zinzza/PlotBridge/Images/plotter1.png

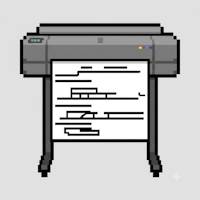
Images/plotter1.png
