zinzza/PlotBridge/Hardware/PlotBridge-schematic.pdf

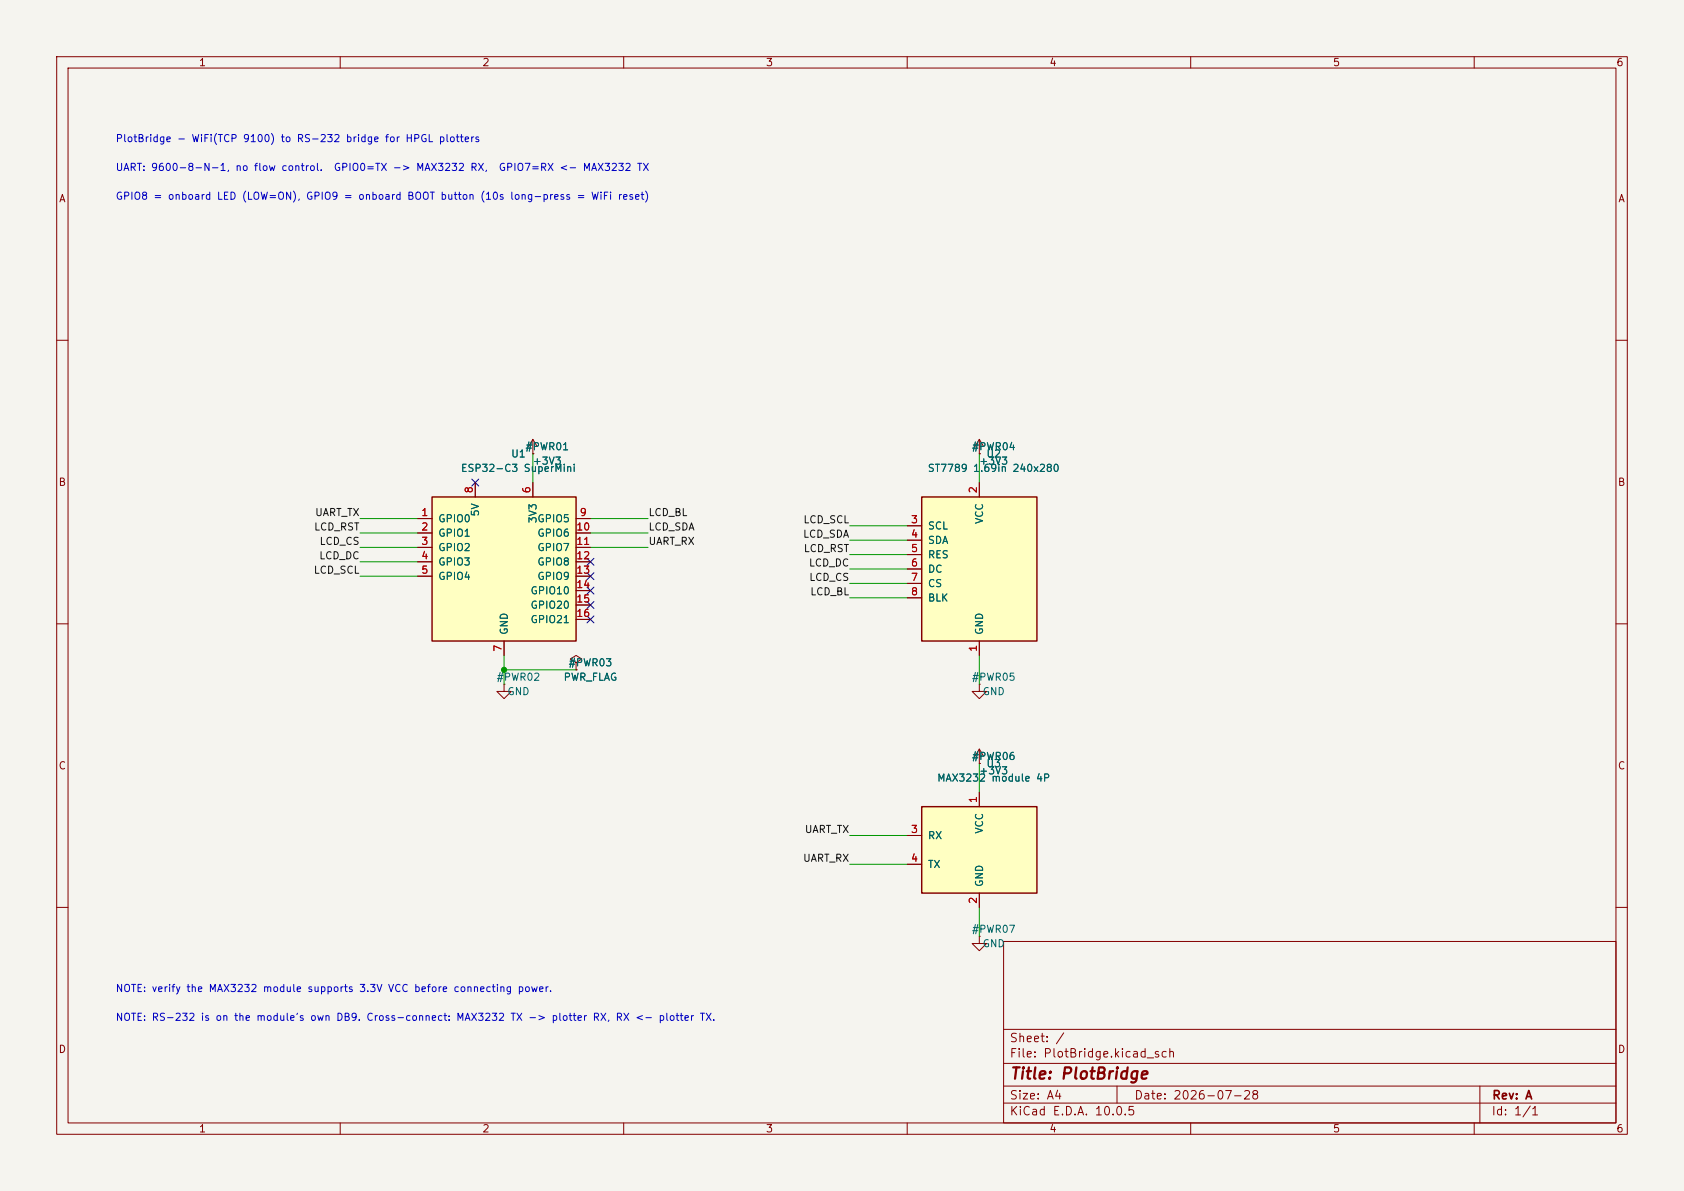
[picture p2: page 1]

GPIO8 = onboard LED (LOW=ON), GPIO9 = onboard BOOT button (10s long-press = WiFi reset) UART: 9600-8-N-1, no flow control. GPIO0=TX -> MAX3232 RX, GPIO7=RX <- MAX3232 TX PlotBridge - WiFi(TCP 9100) to RS-232 bridge for HPGL plotters

Size: A4 | Rev: A
KiCad E.D.A. 10.0.5 | Id: 1/1
