zinzza/PlotBridge/Hardware/PlotBridge.kicad_pcb

## KiCad design Hardware/PlotBridge.kicad_pcb (2026-08-03)

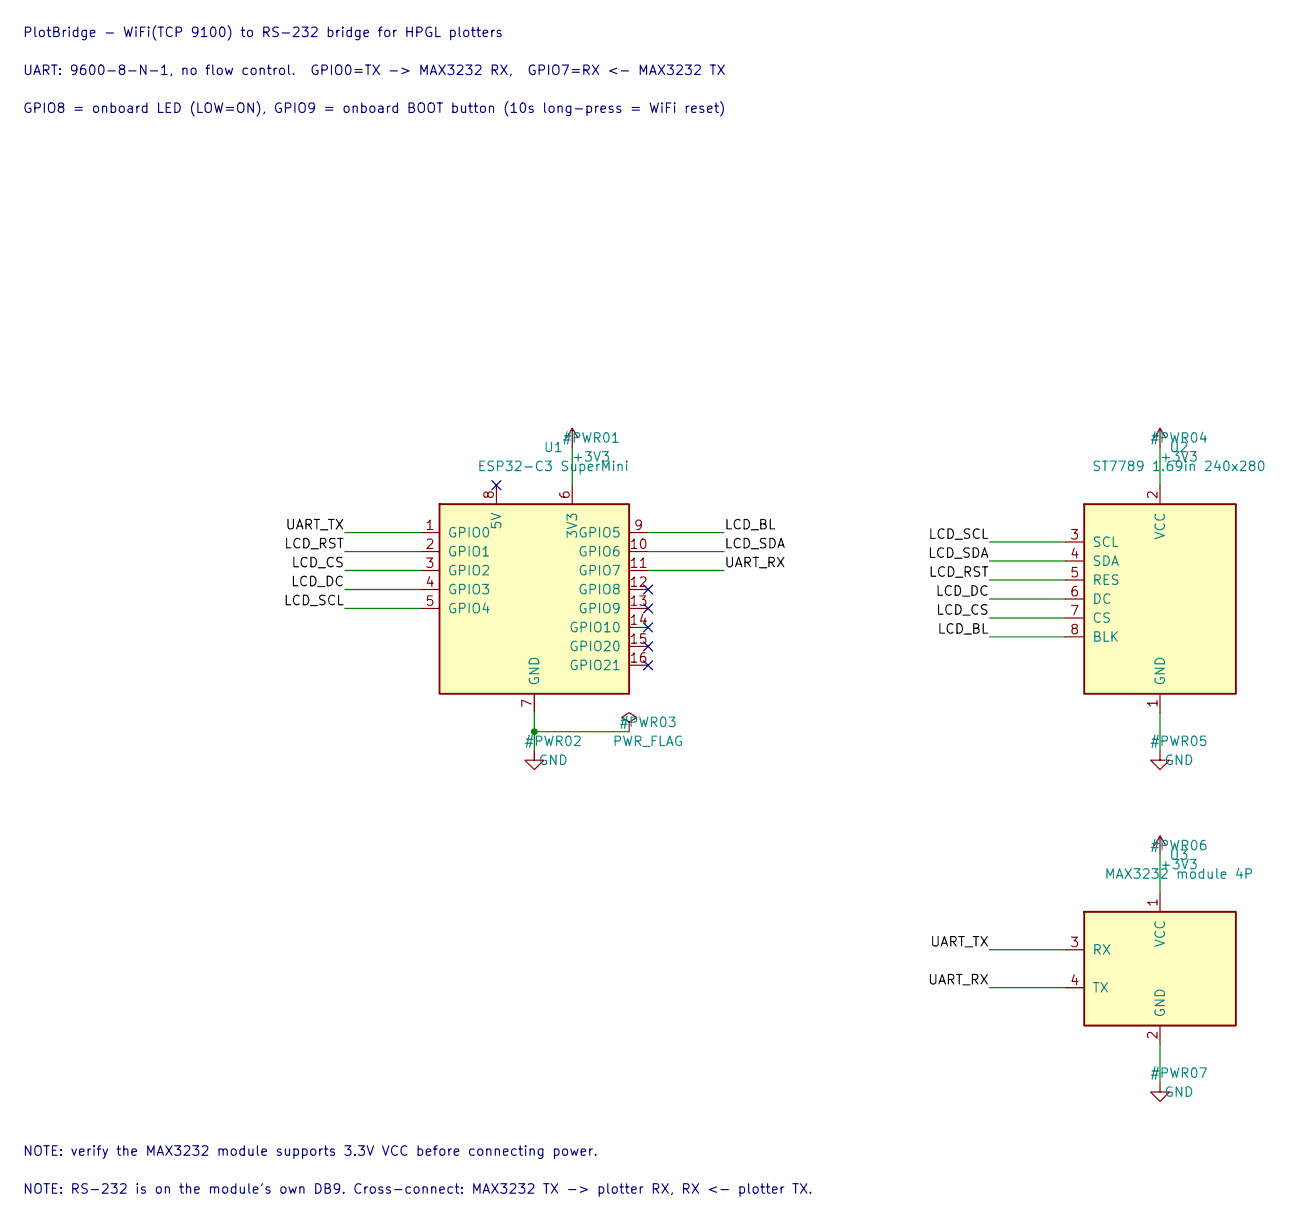
[picture p3: schematic PlotBridge.kicad_sch]

Parts:
U1: ESP32-C3 SuperMini; ESP32-C3_SuperMini
U2: ST7789 1.69in 240x280; ST7789_169_8P
U3: MAX3232 module 4P; MAX3232_MODULE_4P

Connections:
+3V3: U1.6 (3V3), U2.2 (VCC), U3.1 (VCC)
GND: U1.7 (GND), U2.1 (GND), U3.2 (GND)
LCD_BL: U1.9 (GPIO5), U2.8 (BLK)
LCD_CS: U1.3 (GPIO2), U2.7 (CS)
LCD_DC: U1.4 (GPIO3), U2.6 (DC)
LCD_RST: U1.2 (GPIO1), U2.5 (RES)
LCD_SCL: U1.5 (GPIO4), U2.3 (SCL)
LCD_SDA: U1.10 (GPIO6), U2.4 (SDA)
UART_RX: U1.11 (GPIO7), U3.4 (TX)
UART_TX: U1.1 (GPIO0), U3.3 (RX)

Notes on the sheet:
PlotBridge - WiFi(TCP 9100) to RS-232 bridge for HPGL plotters
UART: 9600-8-N-1, no flow control. GPIO0=TX -> MAX3232 RX, GPIO7=RX <- MAX3232 TX
GPIO8 = onboard LED (LOW=ON), GPIO9 = onboard BOOT button (10s long-press = WiFi reset)
NOTE: verify the MAX3232 module supports 3.3V VCC before connecting power.
NOTE: RS-232 is on the module's own DB9. Cross-connect: MAX3232 TX -> plotter RX, RX <- plotter TX.

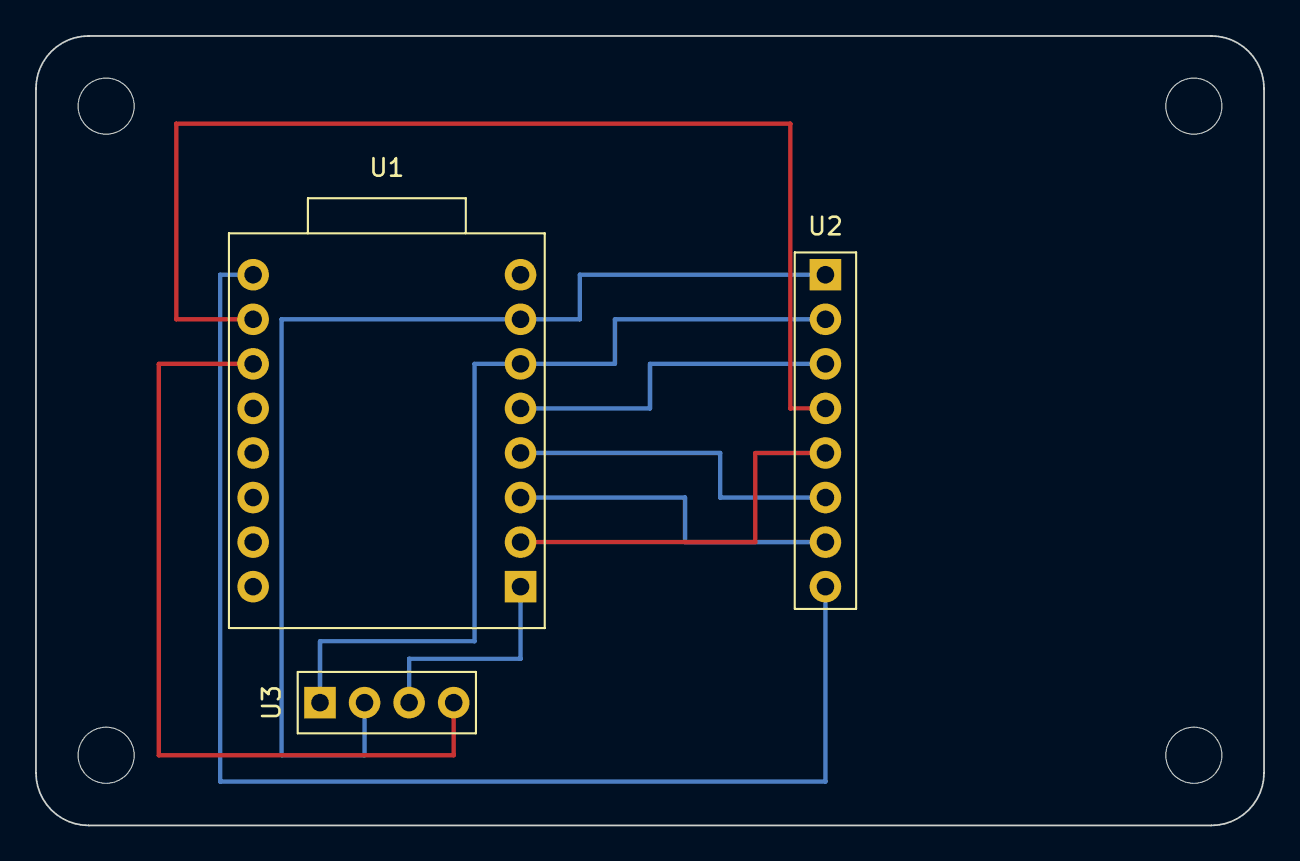
[picture p4: board PlotBridge.kicad_pcb from above]

Board: 2 copper layers, 70.0 x 45.0 mm, 7 parts (0 on the bottom side), 10 nets.

Other parts of the board:
H1, H2, H3, H4: MountingHole_M3
