zinzza/PlotBridge/(commit log)

2026-07-22 PlotBridge: WiFi-Serial bridge for HPGL plotters. ESP32-C3 + ST7789 + MAX3232.
2026-07-22 fix: SPI heap-alloc after WiFiManager, SPIFFS order, boot+WiFi screens
    [PlotBridge.ino]
2026-07-25 docs: sync verified board pin mapping
2026-07-25 docs: sync plan with current bridge behavior
2026-07-25 docs: remove WPS, update MAX3232 pin mapping to VCC
2026-07-25 docs: add circuit diagram
2026-08-03 feat: add selectable display backends and hardware files
    [PlotBridge.kicad_pcb, PlotBridge.kicad_sch]
